swholmstead/DistanceSensor/README.md

<h1>Parking Distance Sensor Project</h1>

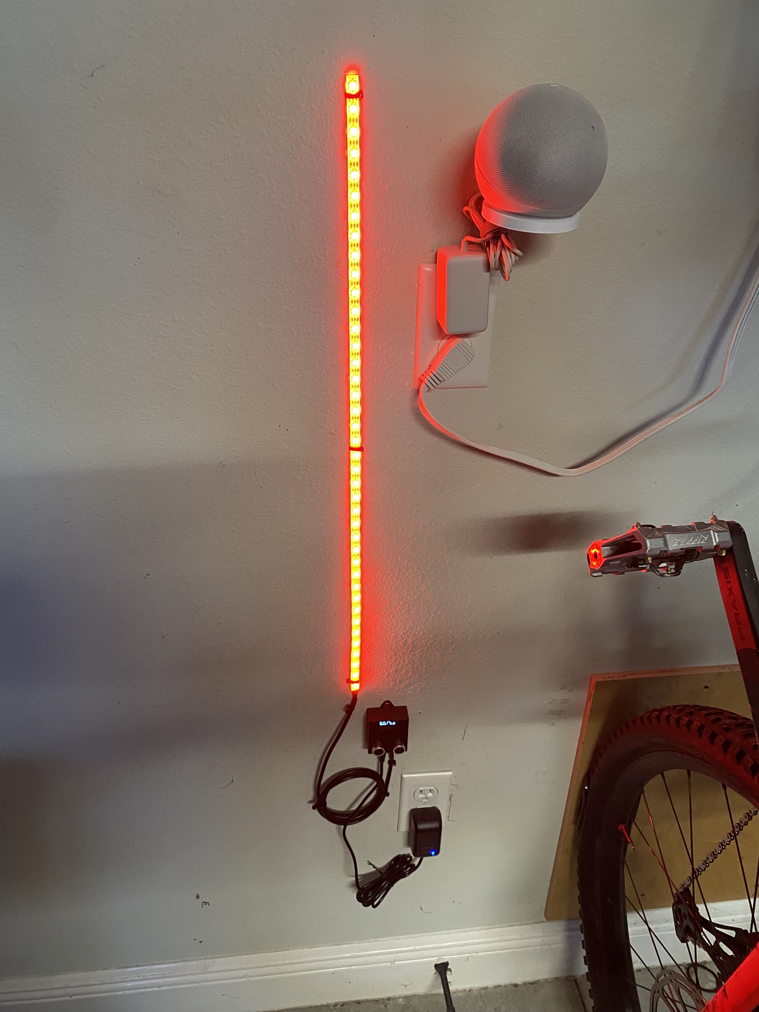
[picture p1: pictures/IMG_3809.JPEG]
Clips


This is a DIY parking sensor to assist you parking your vehicle in the garage.  It is simple to make and
is very affordable.  This project contains everything that you need to build the electronics, 3D print
the case, and download the software.

It uses an ultrasonic distance sensor to detect the distance to the car.  It displays the distance on the OLED
display and uses an LED strip to visual indicate your progress to the "perfect" parking distance.

There is a pushbutton to set the "perfect" parking distance.  Just position your vehicle where you want it to be
and push the SAVE button.  It stores that distance in EEPROM so that it will remember even after power fail.

<h2>Table of Contents</h2>

* [3D Models](https://www.printables.com/model/1478676-diy-garage-parking-sensor)
* [Bill of Materials](docs/bom.md)
* [Schematic and Printed Circuit Board](docs/schematics.md)
* [Arduino IDE and Software](docs/arduino.md)
* [Assembly Instructions](docs/assembly.md)
* [Operation](docs/operation.md)
