swholmstead/DistanceSensor/pictures/IMG_3794.JPEG

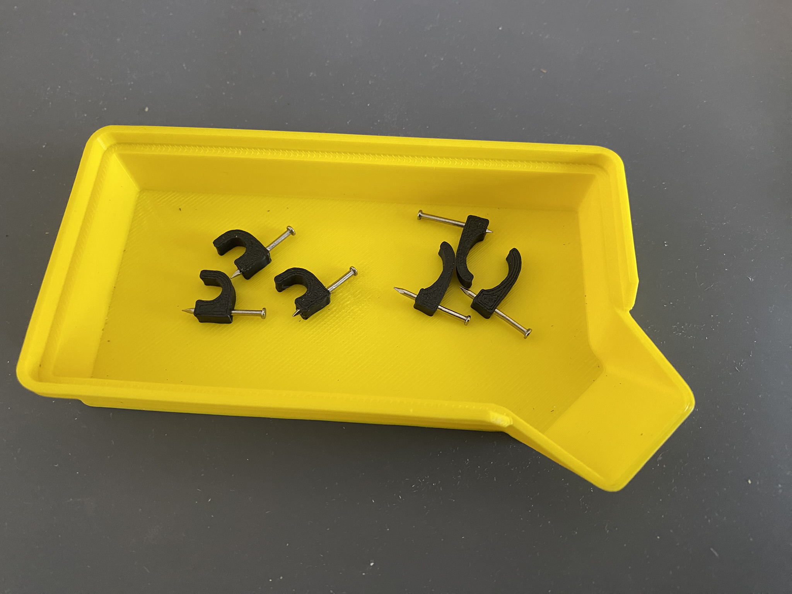
pictures/IMG_3794.JPEG
