swholmstead/DistanceSensor/docs/bom.md

<h2>Bill of Materials</h2>

All of these components are common and can be found online.  I have provided links to Amazon and AliExpress, but these vendors may change over time.
If the links don't work, just search for the components from wherever you shop.

* ESP8266 D1 Mini controller (qty 1) [Amazon](https://www.amazon.com/dp/B0BK986HLZ) [AliExpress](https://www.aliexpress.us/item/3256807691590176.html)
    * There are older versions with micro USB connector.  I prefer the newer version with USB-C connector.  Either will work.
* HC-SR04 Ultrasonic Sensor (qty 1) [Amazon](https://www.amazon.com/dp/B07HQG5K5T) [AliExpress](https://www.aliexpress.us/item/3256808598031205.html)
* SSD1306 OLED Display Module 128 x 32 Pixel (qty 1) [Amazon](https://www.amazon.com/dp/B079BN2J8V) [AliExpress](https://www.aliexpress.us/item/3256807486098308.html)
* WS2812B RGB 5050SMD Individually Addressable LED strip light 60 LED/m DC5V (1m/4ft) [Amazon](https://www.amazon.com/dp/B0956Q3L4Q) [AliExpress](https://www.aliexpress.us/item/3256806929208460.html)
    * This project only needs 40 LEDs.  You can cut the strip to length as long as you cut in the middle of the
      copper solder pads.  
    * You can also change the number of LEDs in software.  NOTE: More LEDs will draw more power, so you may need
      to check power consumption and ensure the power supply can supply it.
    * Make sure you buy the 5V version, NOT 12V or 24V.
    * You can buy different options with various levels of waterproofing
        * IP30 - no waterproofing
        * IP65 - covered in clear silicone (I used this one)
        * IP67 - incased in a waterproof sleeve
* Tact Button switch 2 pin 6x6x5mm (qty 1) [Amazon](https://www.amazon.com/dp/B07X8T9D2Q) [AliExpress](https://www.aliexpress.us/item/3256807146533442.html)
* SN74AHCT125N Quad Bus Buffer (qty 1) [Amazon](https://www.amazon.com/dp/B0DXK7PWTN) [AliExpress](https://www.aliexpress.us/item/3256807624678371.html)
* 2k and 3k 1206 SMD resistors (qty 1 each) [Amazon](https://www.amazon.com/dp/B0BB113PJC) [AliExpress](https://www.aliexpress.us/item/3256807716137879.html)
    * Get the assortment pack with both resistor values in the same set
* PCB Headers 2.54mm pitch round hole[Amazon](https://www.amazon.com/dp/B09WH8N3HX) [AliExpress](https://www.aliexpress.us/item/2251832710374973.html)
    * I like to use the round hole headers because they are lower profile and make the case smaller.
* JST-XH FEMALE connectors 3 pin (qty 1) [Amazon](https://www.amazon.com/dp/B0B2R99X99) [AliExpress](https://www.aliexpress.us/item/3256805824741552.html)
* JST-XH MALE right angle connector 3 pin (qty 1) [Amazon](https://www.amazon.com/dp/B0BMDZR7RZ) [AliExpress](https://www.aliexpress.us/item/3256808303698578.html)
* 22 AWG 3 wire cable (1m/4ft) [Amazon](https://www.amazon.com/dp/B0DNJTMWGB) [AliExpress](https://www.aliexpress.us/item/3256809068712250.html)
* DC Power Barrel FEMALE Jack 2.1mm (qty 1) [Amazon](https://www.amazon.com/dp/B09ZBN38FS) [AliExpress](https://www.aliexpress.us/item/2251832423972836.html)
* 5V 3A DC power supply (qty 1) [Amazon](https://www.amazon.com/dp/B09NLMVXMZ) [AliExpress](https://www.aliexpress.us/item/3256806901002886.html)
* M1.7 x 5mm self-tapping screws (qty 2) [Amazon](https://www.amazon.com/dp/B07GKXMSVR) [AliExpress](https://www.aliexpress.us/item/3256808546142529.html)
* Wire Brads - 18 awg x 5/8" or 1.2mm x 15.9mm [Amazon](https://www.amazon.com/dp/B001F9R2L0) [AliExpress](https://www.aliexpress.us/item/3256805095938829.html)
