swholmstead/DistanceSensor/docs/operation.md

<h2>Operation</h2>

Attach case to wall at vehicle bumper height and route LED strip to about eye height while sitting in vehicle.
Plug LED strip into case.  Secure cable and LEDs with clips.

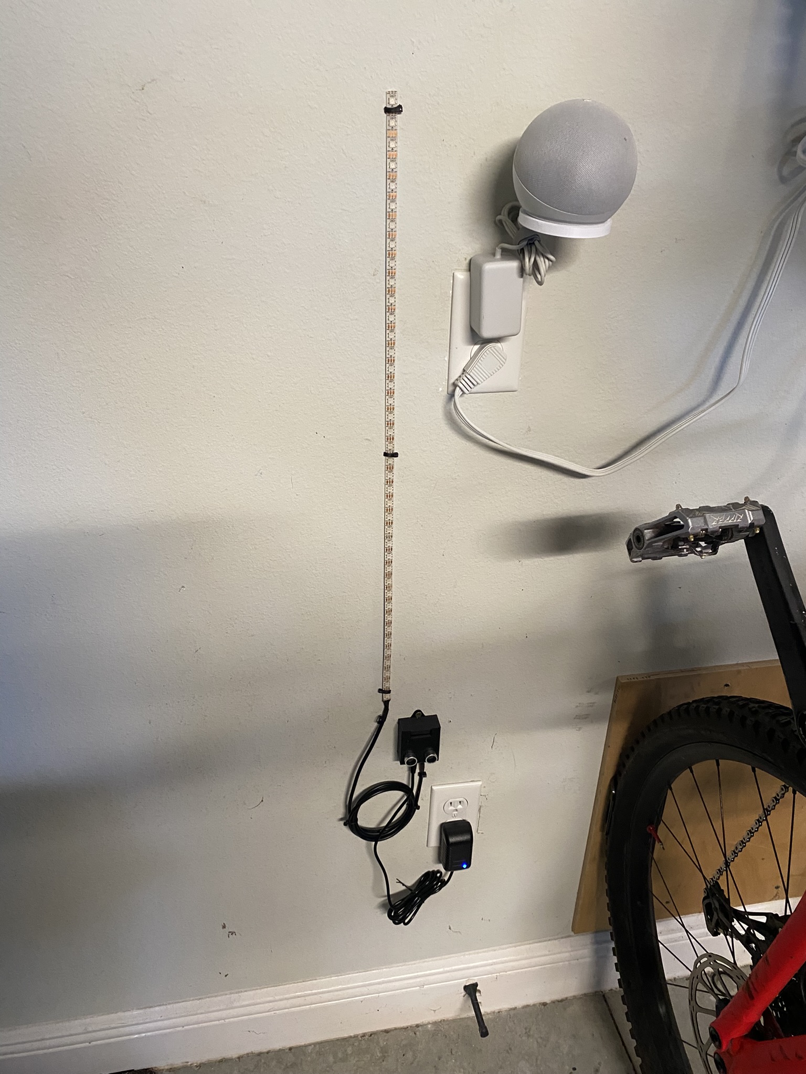
[picture p5: pictures/IMG_3807.JPEG]


Plug in 5V power supply.  Circuit will start immediately.

Move vehicle to ideal parking spot and press Save Button.  This will save the vehicle current position
distance in the EEPROM.

Back out vehicle and pull in to verify operation.

<div style="display: flex; gap: 20px">
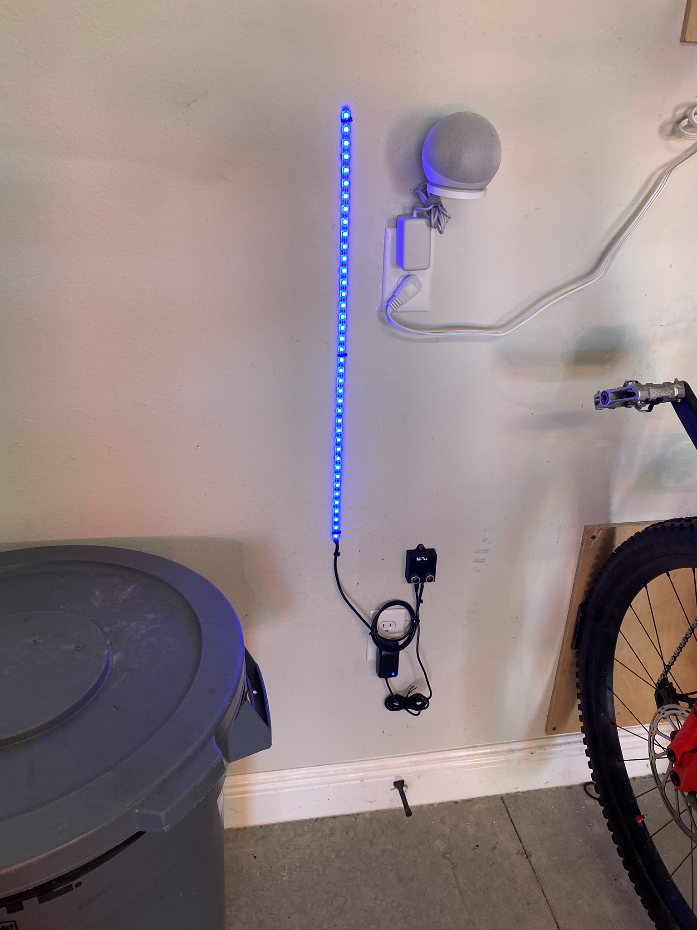
[picture p6: pictures/IMG_3811.JPEG]

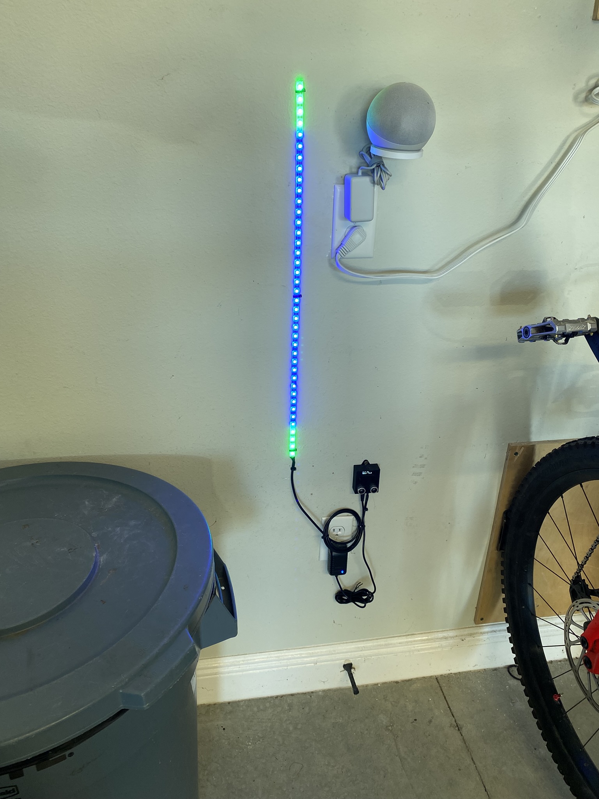
[picture p7: pictures/IMG_3812.JPEG]

</div>
<div style="display: flex; gap: 20px">
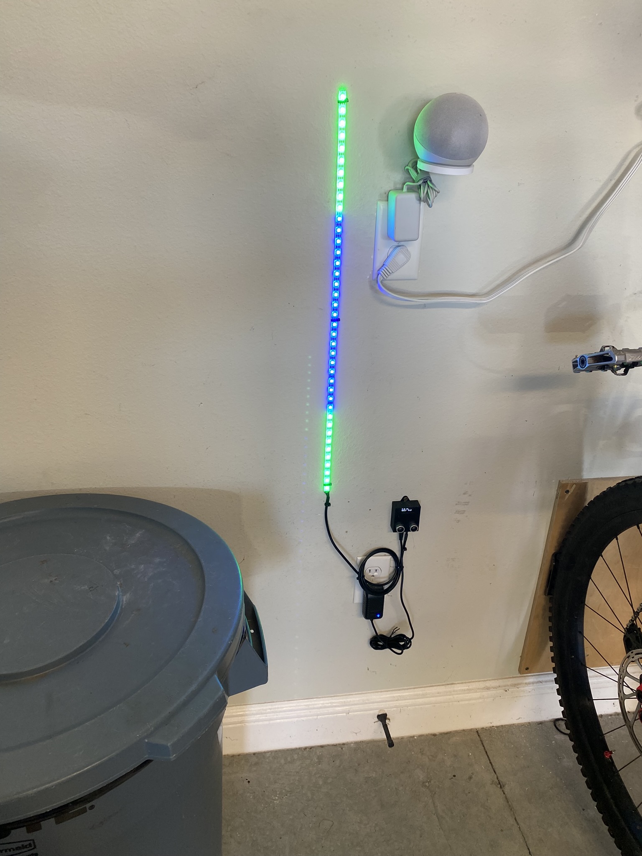
[picture p8: pictures/IMG_3813.JPEG]

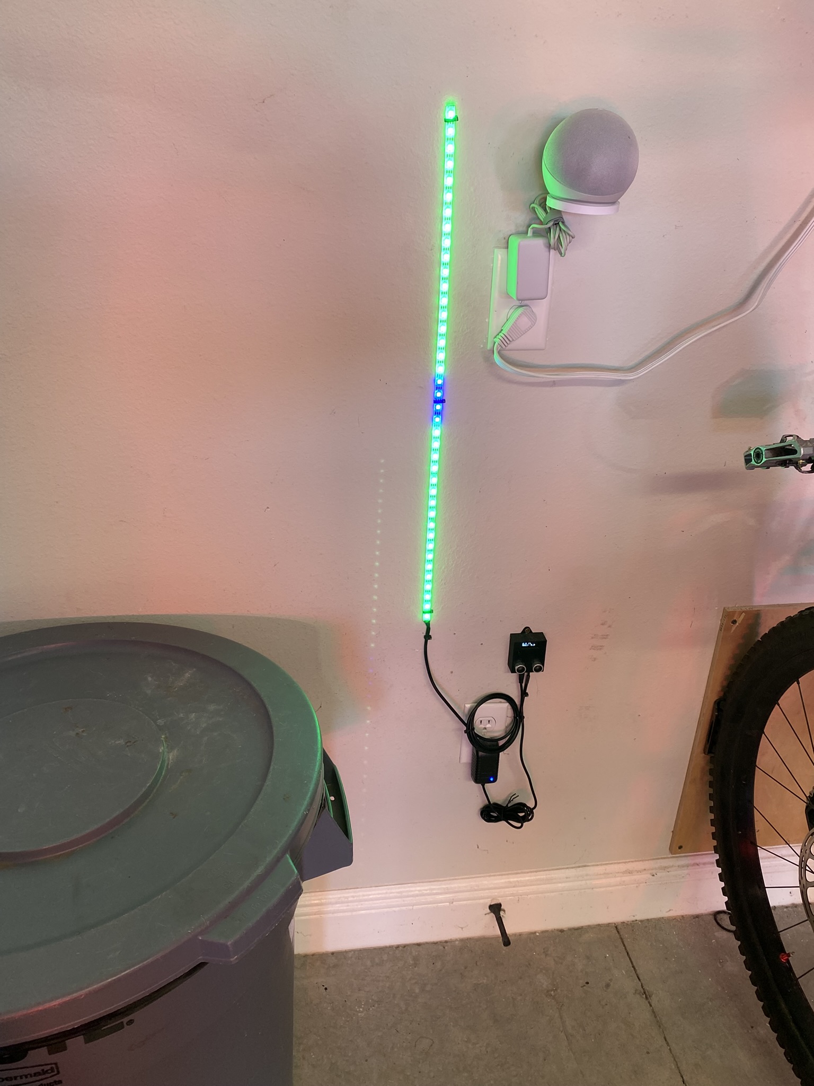
[picture p9: pictures/IMG_3814.JPEG]

</div>
<div style="display: flex; gap: 20px">
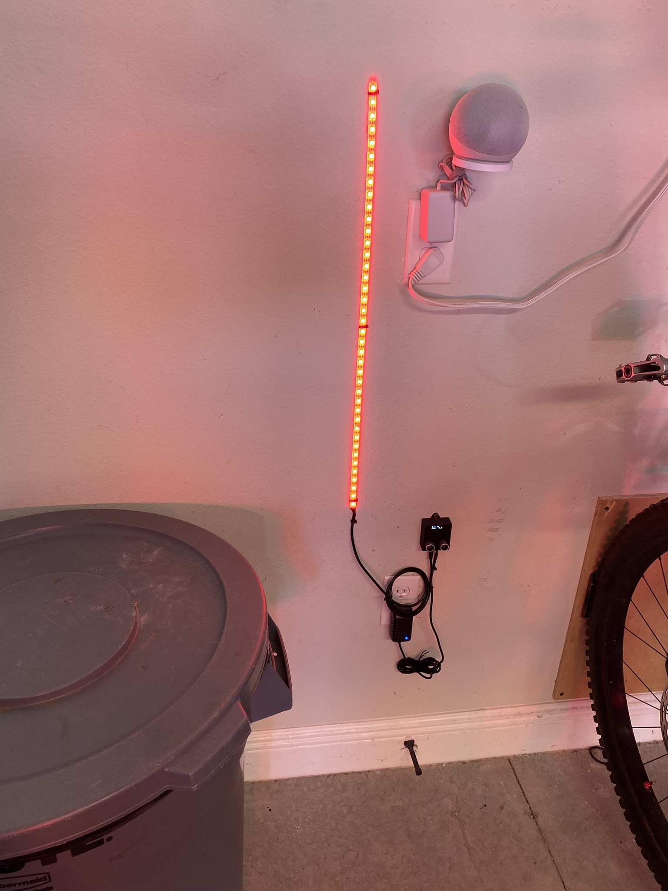
[picture p10: pictures/IMG_3815.JPEG]

</div>

LED strip will glow faint BLUE when it recognizes a vehicle within about 8 feet.  As you get closer, the GREEN
lights will gradually close in towards the center.  When vehicle is in ideal parking spot, LEDs will turn RED.

System will automatically timeout and turn off after 7 seconds of nothing moving.
