swholmstead/DistanceSensor/docs/assembly.md

<h2>Assembly Instructions</h2>

<h3>LED strip</h3>

Cut 40 LEDs from the spool of WS2812B lights at the copper pads between LEDs.  Remove any waterproofing from over the pad on the side with the arror pointing AWAY from the copper pad.

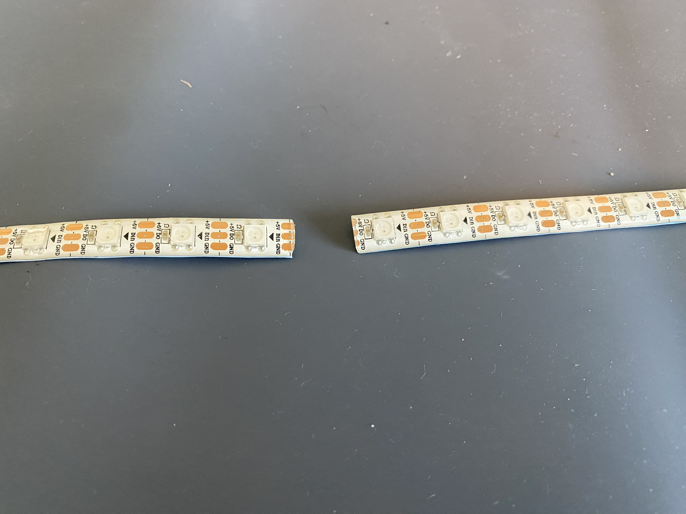
[picture p11: pictures/IMG_3783.JPEG]


Cut about 100 cm (40 inches) of the 22 AWG 3 wire cable. Remove 2 cm of the outer cable from each end.  Strip off
about 3mm from each wire and solder the wires to the exposed pad.

* +5V - RED
* Din - YELLOW
* GND - BLACK

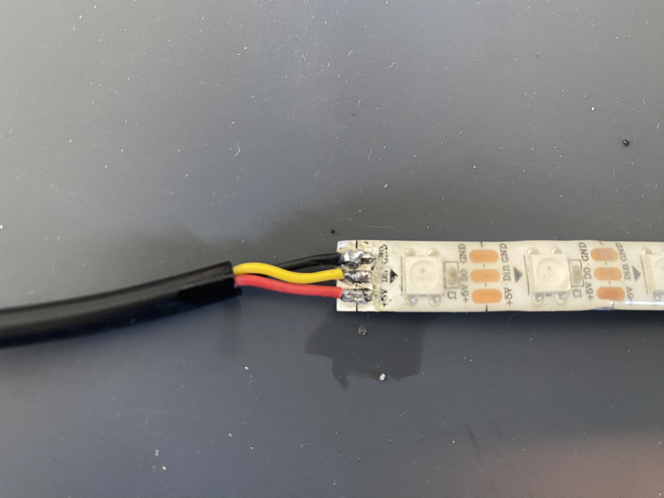
[picture p12: pictures/IMG_3784.JPEG]


Crimp JST XH connectors to other end of cable and insert into FEMALE 3-pin JST-XH connector in the same order as shown.

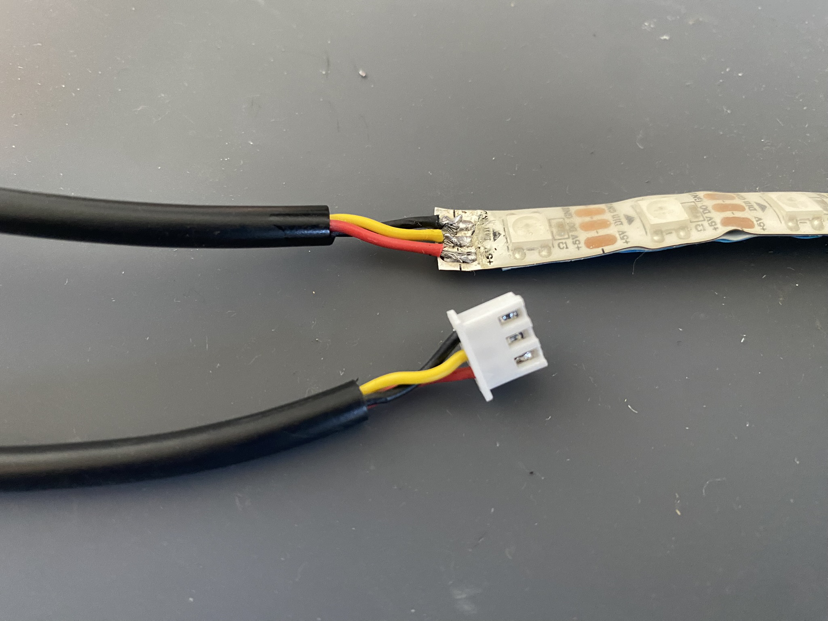
[picture p13: pictures/IMG_3785.JPEG]


Add shrink tubing to both ends (optional).

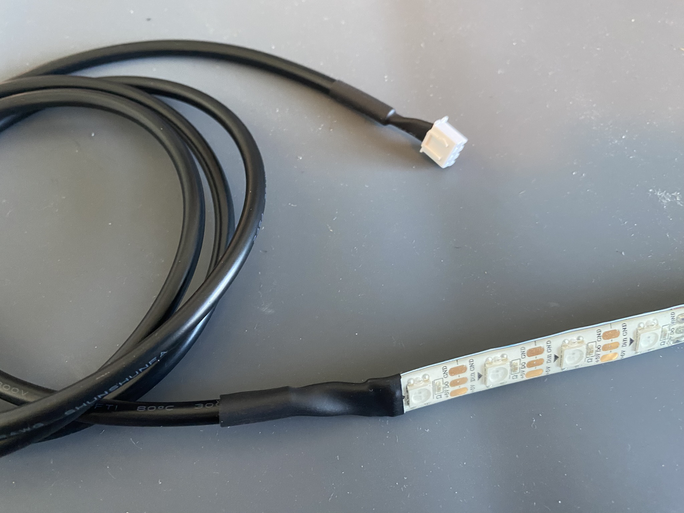
[picture p14: pictures/IMG_3787.JPEG]


<h3>Electronics assembly</h3>

Solder the following components onto the front side of the PCB.

* R1 - 2K 1206 SMD resistor
* R2 - 3K 1206 SMD resistor
* CONFIG - Tact button switch
* TTL-BUFFER - SN74AHCT125N Quad Bus Buffer chip.
    * ENSURE Pin 1 is aligned with dot on PCB.

Trim off pins on back side of PCB to be flush with board (doesn't need to be perfectly flush).

PCB
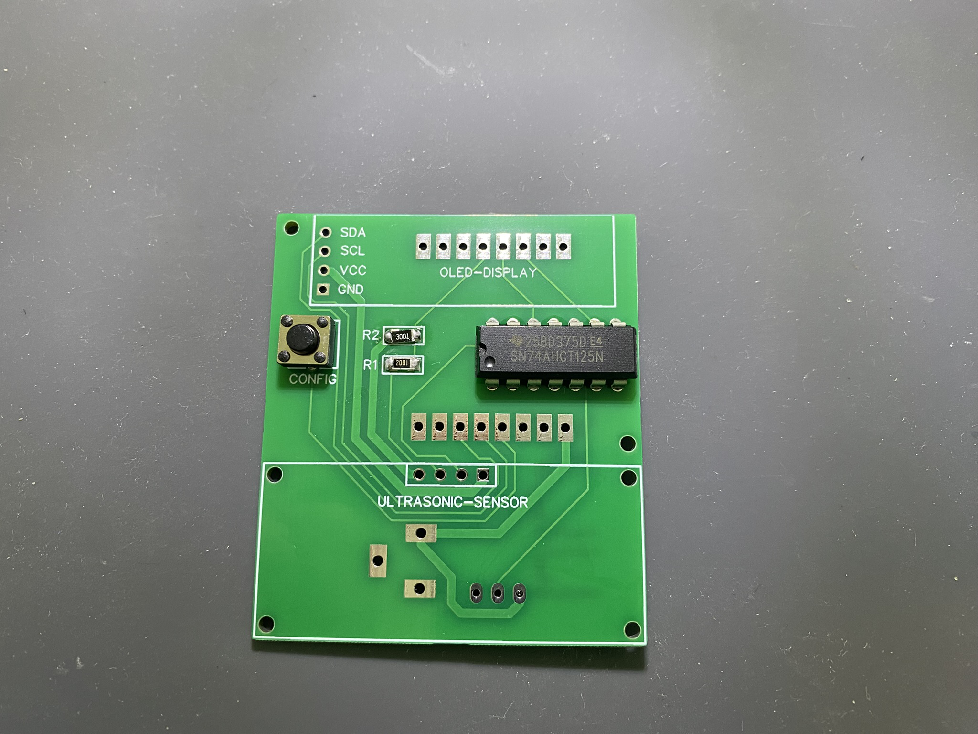
[picture p15: pictures/IMG_3795.JPEG]


Solder the following components onto the back side of the PCB.

* 8 pin headers on boths sides of where the ESP8266 processor will go
* LED-STRIP - 3 pin right angle JST-XH connector
* POWER - DC Power barrel female jack 2.1mm

Trim off pins on front side of PCB to be flush with board.

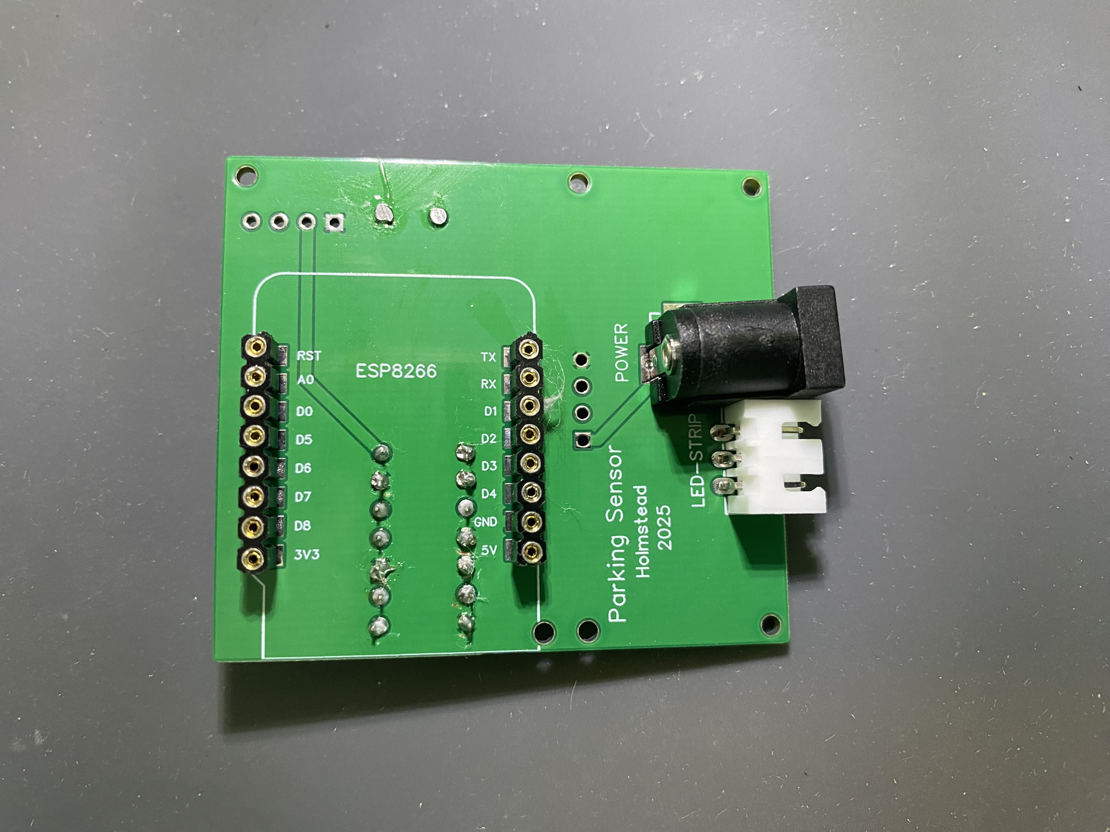
[picture p16: pictures/IMG_3797.JPEG]


Cover the area under where the SSD-1306 OLED display will go with electrical tape
to ensure this component will not short with the PCB.

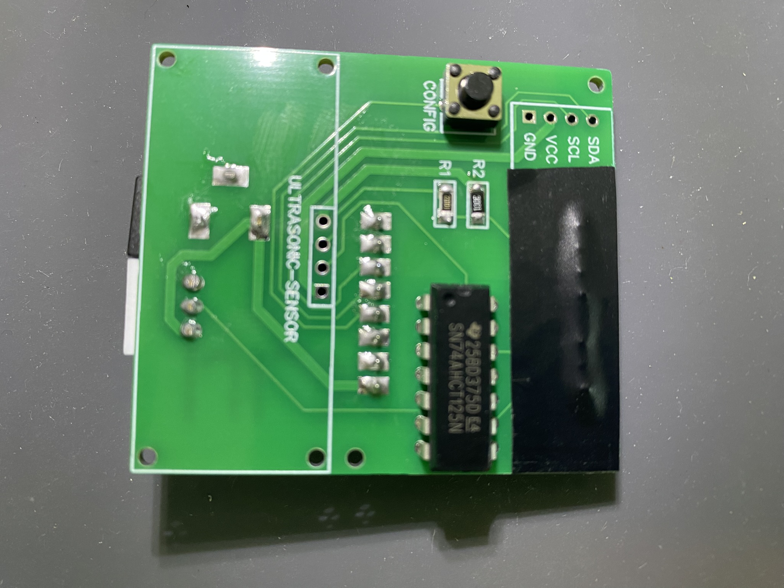
[picture p17: pictures/IMG_3798.JPEG]


Bend the pins on the HC-SR04 ultrasonic sensor so they are straight.  Then cover the back
with electrical tape to ensure this component will not short with the PCB.

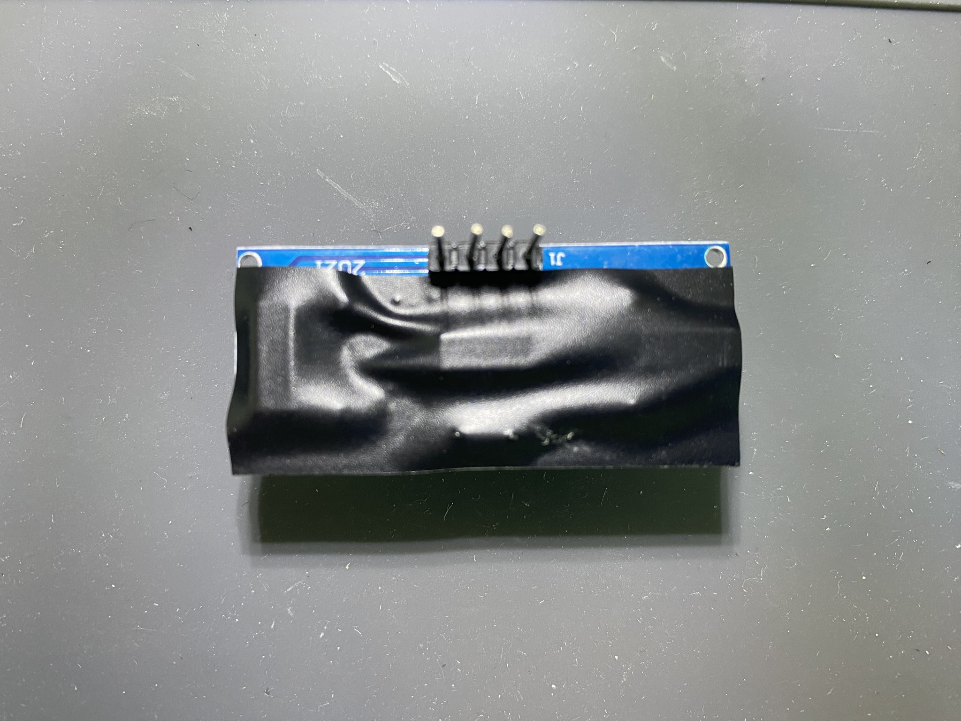
[picture p18: pictures/IMG_3799.JPEG]


Solder a 4 pin header onto the SSD1306 OLED display with the pins behind the display.
Solder the OLED display to the PCB.  Insert Display Offset 3D printed part behind the right side of the display
to stablize it.

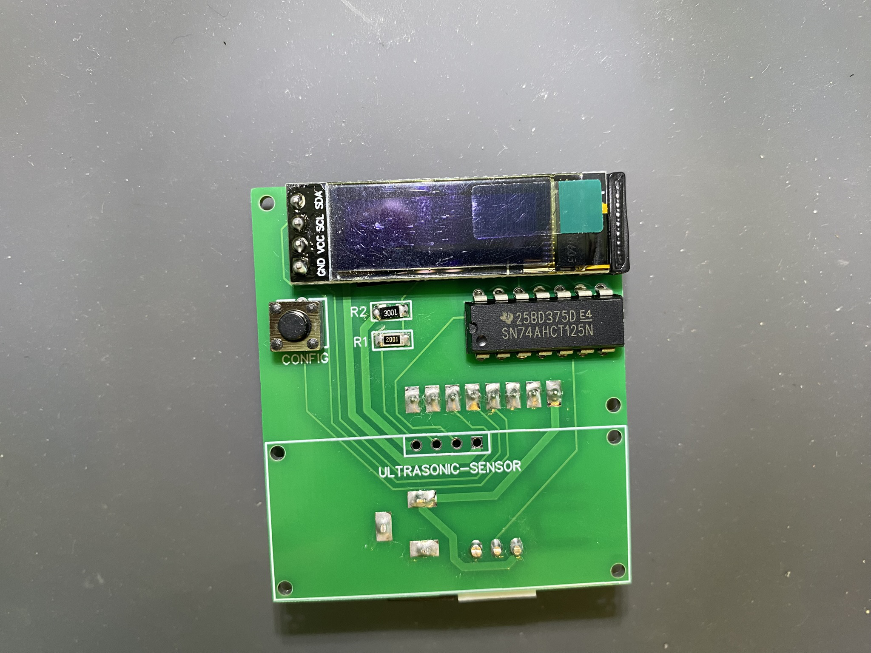
[picture p19: pictures/IMG_3800.JPEG]


Solder the HC-SR04 onto the PCB.

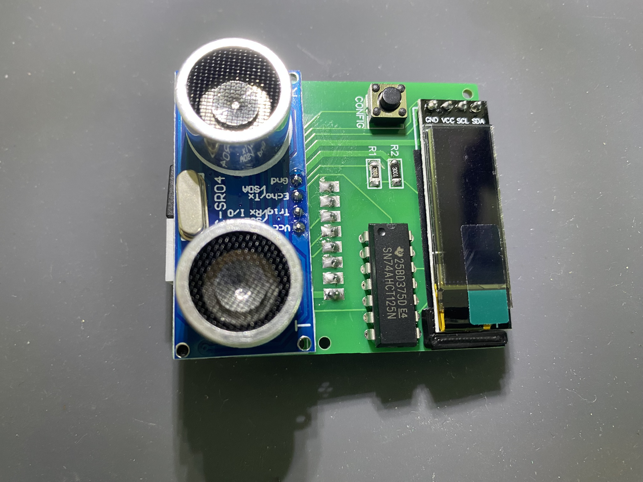
[picture p20: pictures/IMG_3801.JPEG]


Add the following components to the PCB:

* ESP8266 D1 Mini

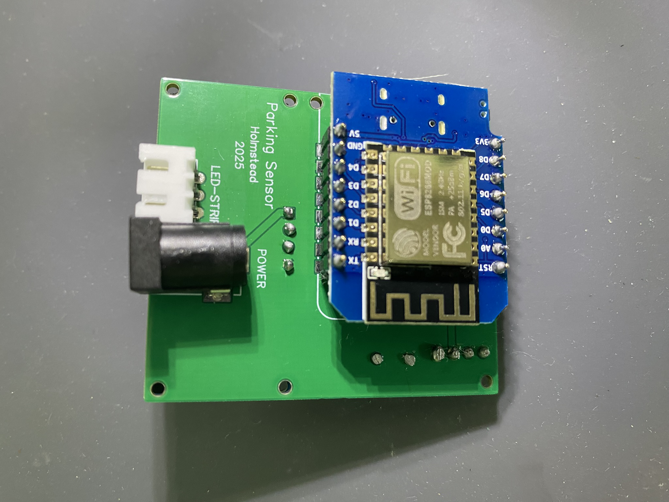
[picture p21: pictures/IMG_3804.JPEG]


Insert the power supply to ensure PCB powers on.

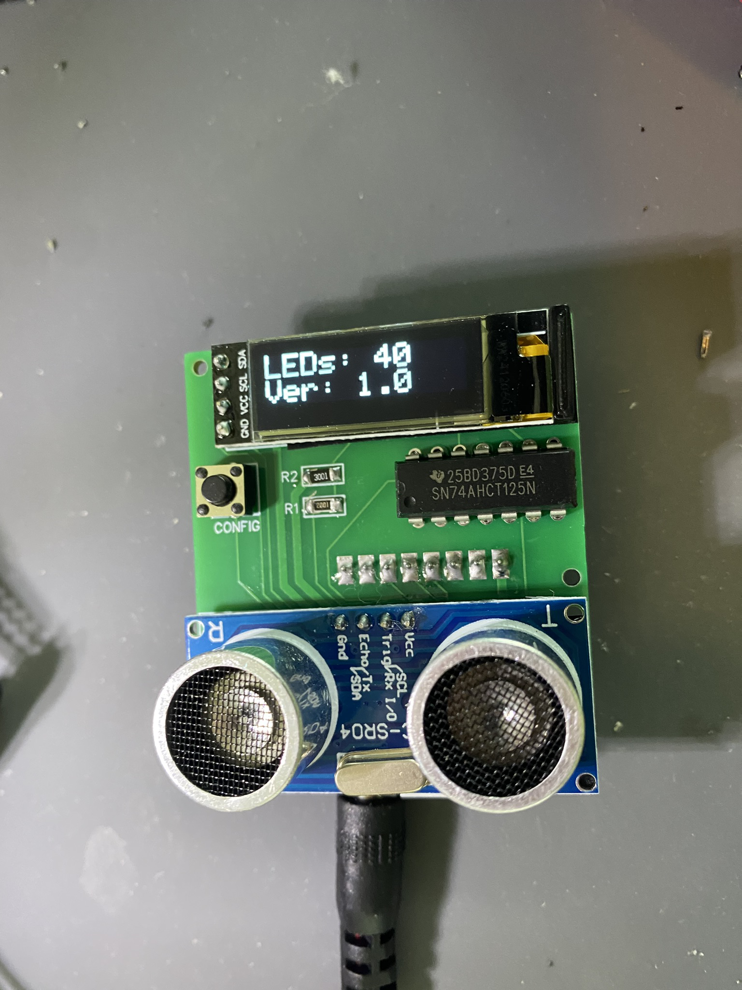
[picture p22: pictures/IMG_3802.JPEG]


<h3>Controller Case</h3>

Insert Save Button into back of 3D printed case.  Insert circuit board into case.  Secure with 2 M1.7 x 5mm screws.
Use care not to bend ultrasonic sensor when inserting screws.  Test Save Button.  You should feel a tactile click
when pushing.

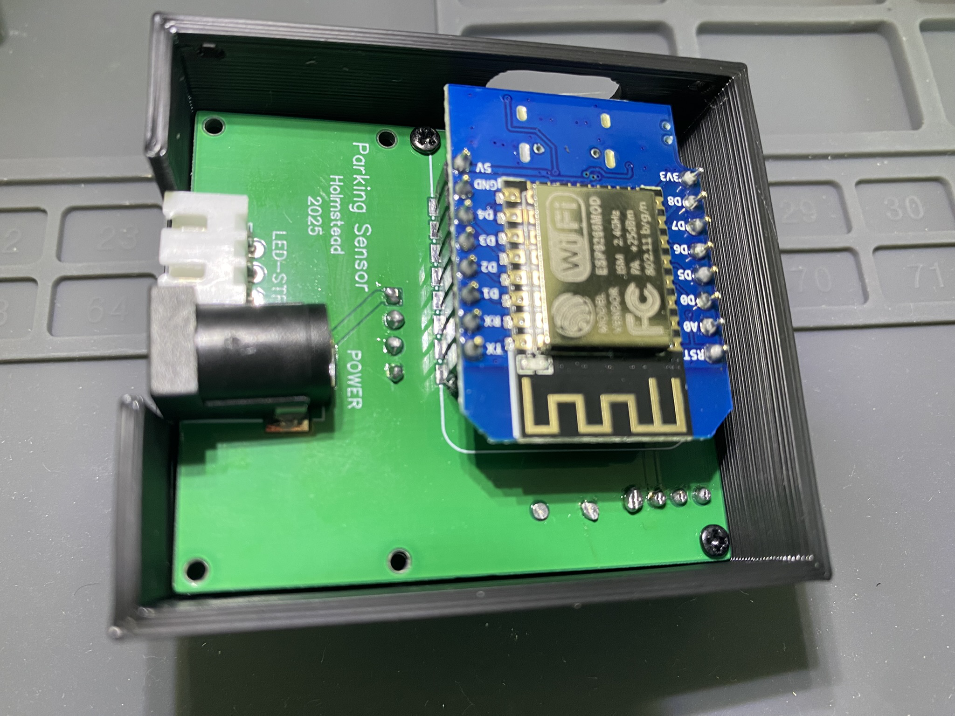
[picture p23: pictures/IMG_3805.JPEG]


Attach case back with 4 M1.7 x 5mm screws.

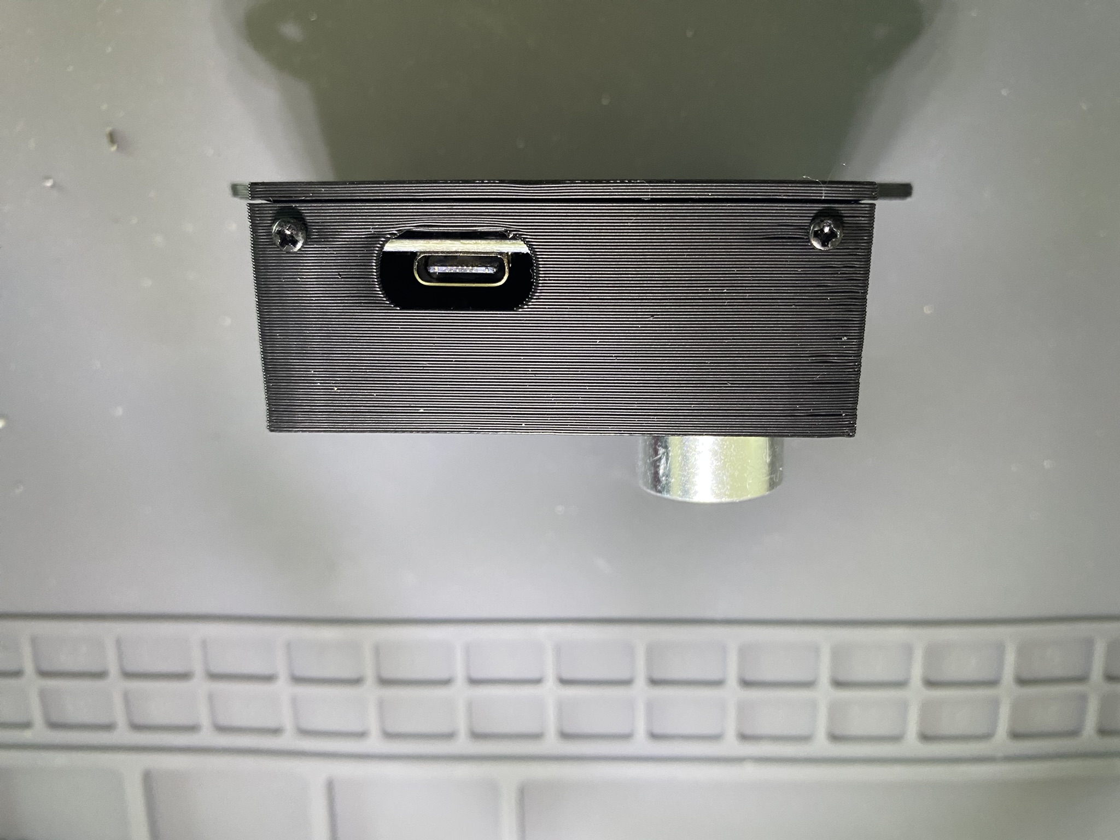
[picture p24: pictures/IMG_3806.JPEG]
