swholmstead/DistanceSensor/(commit log)

2025-09-30 Updated PCB layout
2025-10-01 Added Logic Level converter to PCB
2025-10-04 Fixed idle timeout when red
    [DistanceSensor.ino]
2025-10-04 added date to Gerber file
2025-10-04 Updated PCB
2025-10-04 Finished BOM
2025-10-04 Add button to BOM
2025-10-17 Increased brightness of LED strip
    At full power, strip consumes 0.5A max.
2025-10-17 Increased to 40 LEDs
2025-10-21 Removed LED_BUILTIN logic
2025-10-25 LED and display init sequence
2025-10-30 Added screws to BOM
2025-10-31 Added running LED on init
2025-11-01 Updated assembly instructions
2025-11-02 Added LED and cable clips
2025-11-11 Added assembly instructions
